leoliuuu/Eclectronics_final/image_scripts/batttery_0.jpg

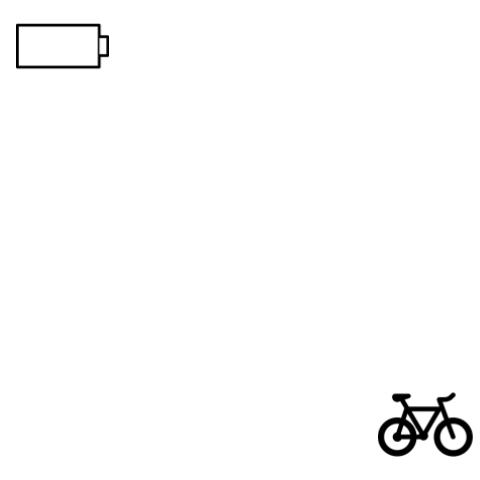
image_scripts/batttery_0.jpg
