leoliuuu/Eclectronics_final/image_scripts/full_battery.jpg

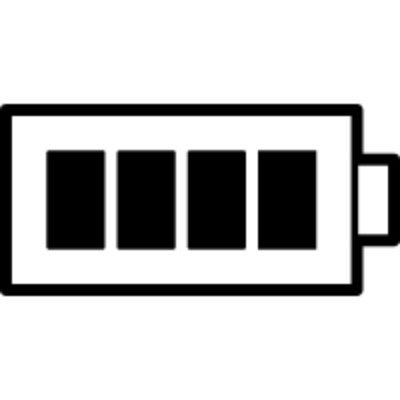
image_scripts/full_battery.jpg
