leoliuuu/Eclectronics_final/final/3dshapes/CSTNE.step

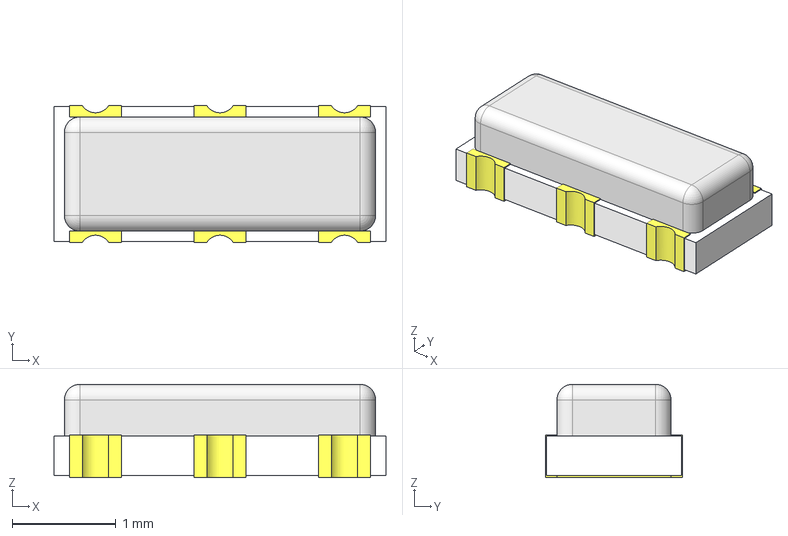
[picture p4: CAD file, 2019-04-07]
final/3dshapes/CSTNE.step
3.20 x 1.32 x 0.9 mm
