leoliuuu/Eclectronics_final/final/3dshapes/QFN-32_5x5.stp

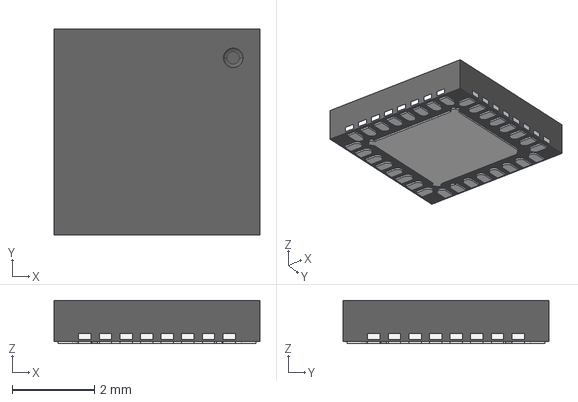
[picture p5: CAD file, 2019-04-07]
final/3dshapes/QFN-32_5x5.stp
5.00 x 5.00 x 1.05 mm
