leoliuuu/Eclectronics_final/image_scripts/test_image.png

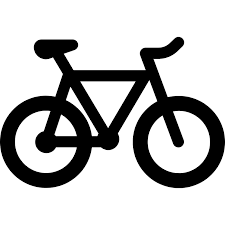
image_scripts/test_image.png
