leoliuuu/Eclectronics_final/final/sensor_board.kicad_pcb

## KiCad design final/sensor_board.kicad_pcb (2019-04-29)

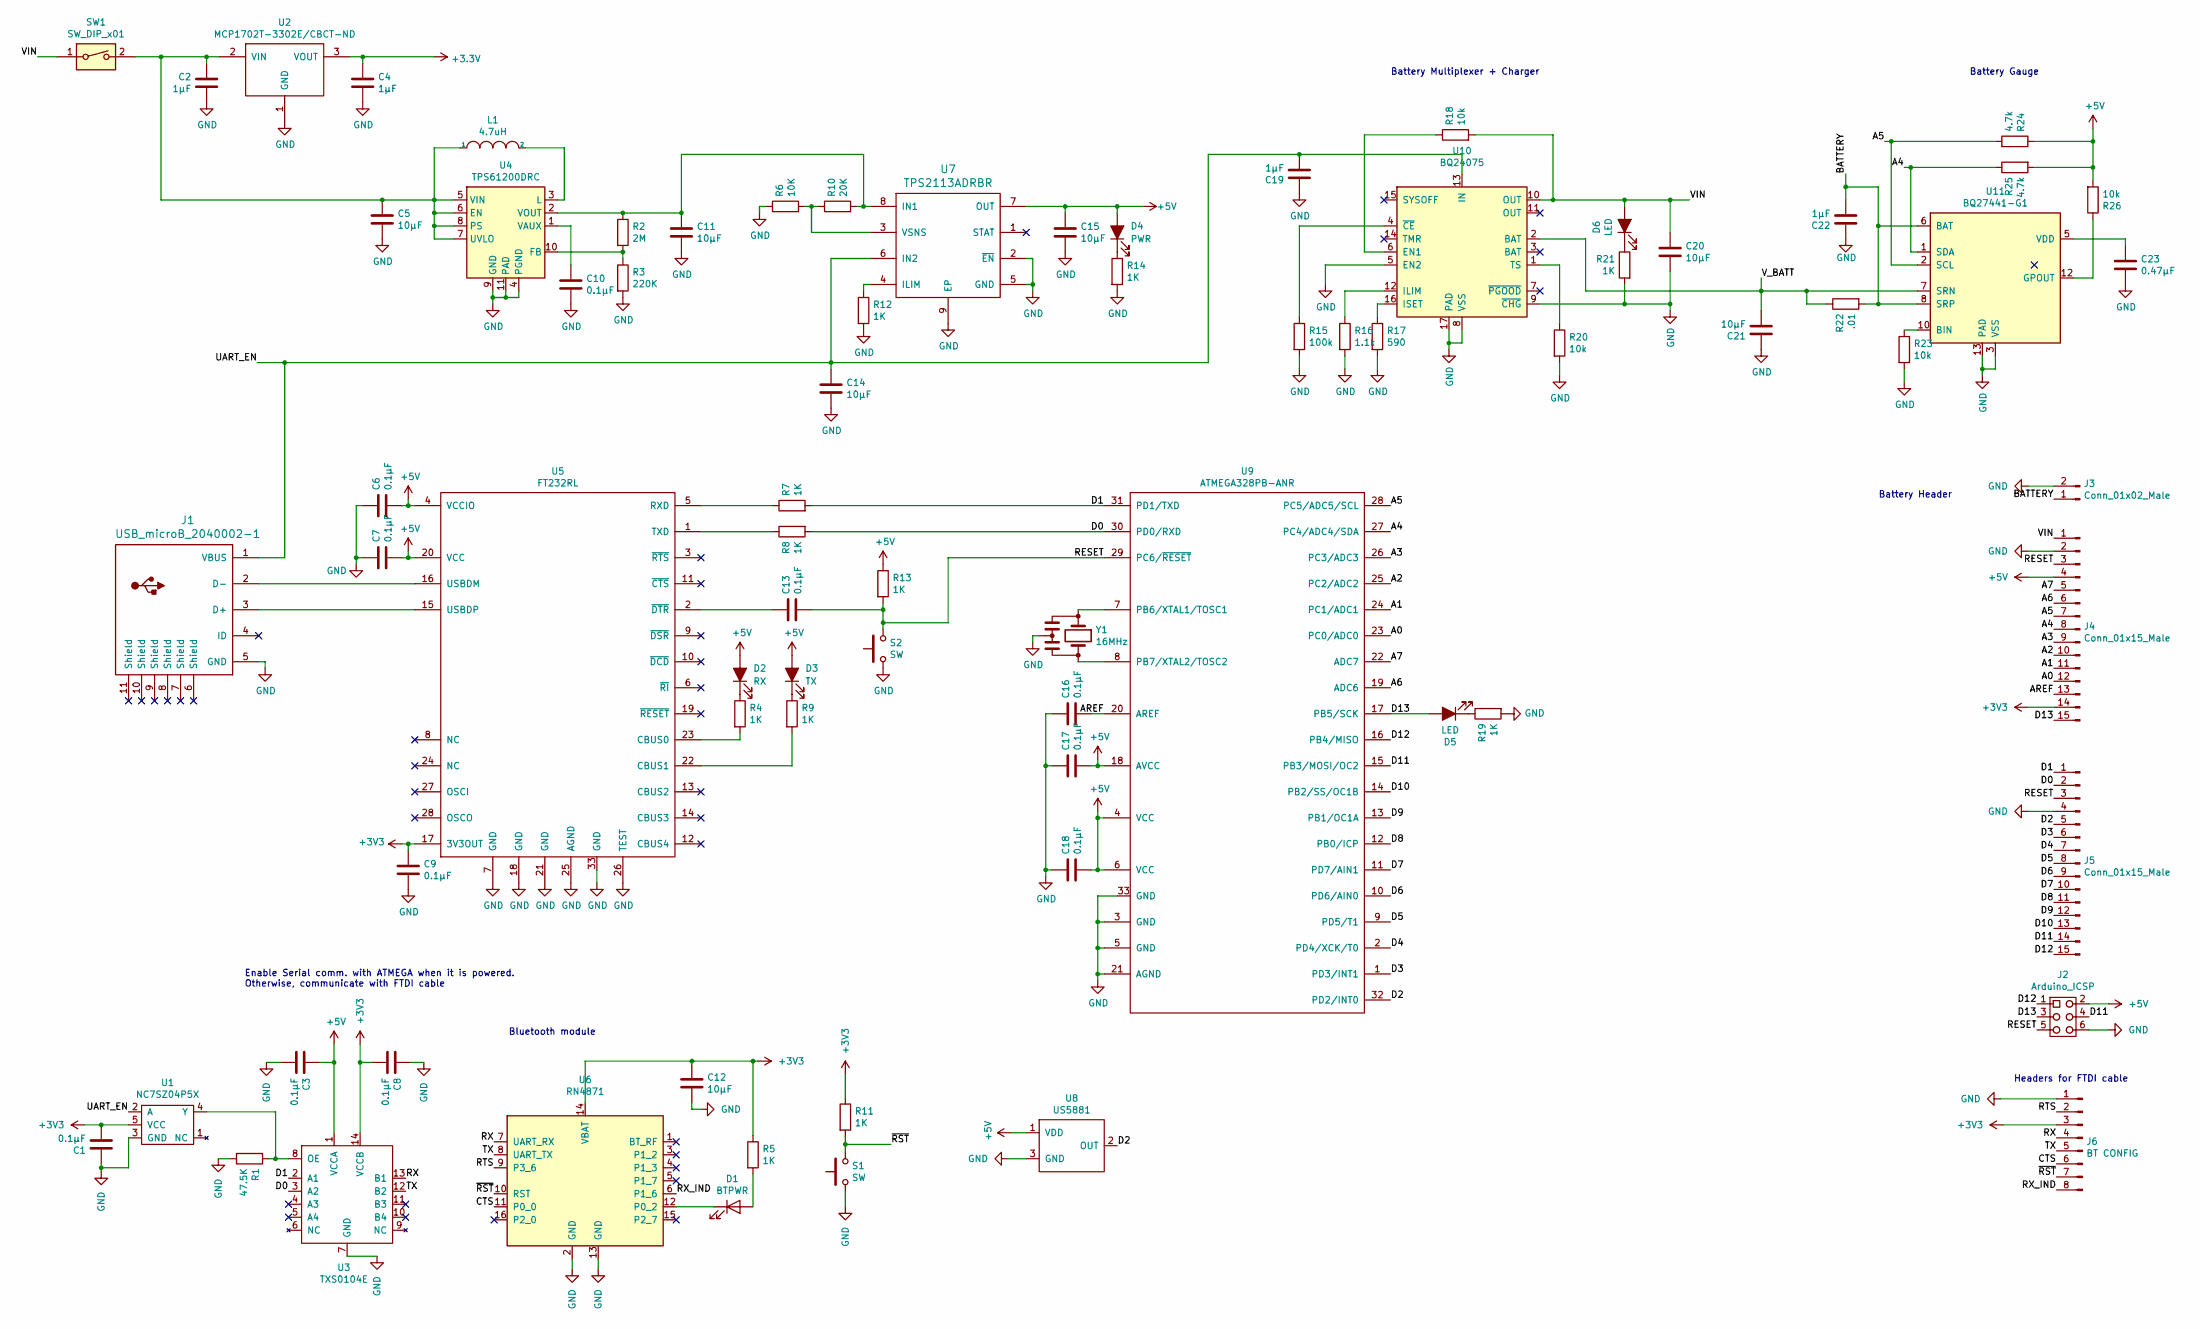
[picture p7: schematic sensor_board.sch]

Parts:
C1, C3, C6, C7, C8, C9, C10, C13, C16, C17, C18: 0.1µF; C_0603_1608Metric
C2, C4, C19, C22: 1µF; C_0603_1608Metric
C5, C11, C20, C21: 10µF; C_0603_1608Metric
C12, C14, C15: 10µF; C_0805_2012Metric
C23: 0.47µF; C_0402_1005Metric
D1: BTPWR; LED_0805_2012Metric
D2: RX; LED_0805_2012Metric
D3: TX; LED_0805_2012Metric
D4: PWR; LED_0805_2012Metric
D5, D6: LED; LED_0805_2012Metric
J1: USB_microB_2040002-1
J2: Arduino_ICSP
J3: Conn_01x02_Male; JST-2-SMD
J4, J5: Conn_01x15_Male; PinHeader_1x15_P2.54mm_Vertical
J6: BT CONFIG; PinHeader_1x08_P2.54mm_Vertical
L1: 4.7uH; CDRH2D18HP
R1: 47.5K; R_0603_1608Metric
R2: 2M; R_0603_1608Metric
R3: 220K; R_0603_1608Metric
R4, R5, R7, R8, R9, R11, R12, R13, R14, R19, R21: 1K; R_0603_1608Metric
R6: 10K; R_0603_1608Metric
R10: 20K; R_0603_1608Metric
R15: 100k; R_0603_1608Metric
R16: 1.1k; R_0603_1608Metric
R17: 590; R_0603_1608Metric
R18, R20, R23, R26: 10k; R_0603_1608Metric
R22: .01; R_0603_1608Metric
R24, R25: 4.7k; R_0603_1608Metric
S1, S2: SW; SW_SPST_B3U-1000P
SW1: SW_DIP_x01; KAE01SGGt
U1: NC7SZ04P5X
U2: MCP1702T-3302E/CBCT-ND; SOT-23
U3: TXS0104E; txs0104e
U4: TPS61200DRC
U5: FT232RL; FT232RQ
U6: RN4871; Microchip_RN4871
U7: TPS2113ADRBR
U8: US5881; TSOT-3L
U9: ATMEGA328PB-ANR; Atmega328pb
U10: BQ24075
U11: BQ27441-G1; Texas_S-PDSO-N12
Y1: 16MHz; CSTNE

Connections:
+5V: C3.1, C6.2, C7.2, C15.1, C17.2, C18.2, D2.2 (A), D3.2 (A), D4.2 (A), J2.2, J4.4, R13.1, R24.1, R25.2, R26.2, U3.1 (VCCA), U5.4 (VCCIO), U5.20 (VCC), U7.7 (OUT), U8.1 (VDD), U9.4 (VCC), U9.6 (VCC), U9.18 (AVCC)
/A0: J4.12, U9.23 (PC0/ADC0)
/A1: J4.11, U9.24 (PC1/ADC1)
/A2: J4.10, U9.25 (PC2/ADC2)
/A3: J4.9, U9.26 (PC3/ADC3)
/A4: J4.8, R25.1, U9.27 (PC4/ADC4/SDA), U11.1 (SDA)
/A5: J4.7, R24.2, U9.28 (PC5/ADC5/SCL), U11.2 (SCL)
/A6: J4.6, U9.19 (ADC6)
/A7: J4.5, U9.22 (ADC7)
/AREF: C16.2, J4.13, U9.20 (AREF)
/BATTERY: C22.2, J3.1, R22.2, U11.6 (BAT), U11.8 (SRP)
/CTS: J6.6, U6.11 (P0_0)
/D0: J5.2, R8.2, U3.3 (A2), U9.30 (PD0/RXD)
/D1: J5.1, R7.2, U3.2 (A1), U9.31 (PD1/TXD)
/D2: J5.5, U8.2 (OUT), U9.32 (PD2/INT0)
/D3: J5.6, U9.1 (PD3/INT1)
/D4: J5.7, U9.2 (PD4/XCK/T0)
/D5: J5.8, U9.9 (PD5/T1)
/D6: J5.9, U9.10 (PD6/AIN0)
/D7: J5.10, U9.11 (PD7/AIN1)
/D8: J5.11, U9.12 (PB0/ICP)
/D9: J5.12, U9.13 (PB1/OC1A)
/D10: J5.13, U9.14 (PB2/SS/OC1B)
/D11: J2.4, J5.14, U9.15 (PB3/MOSI/OC2)
/D12: J2.1, J5.15, U9.16 (PB4/MISO)
/D13: D5.2 (A), J2.3, J4.15, U9.17 (PB5/SCK)
/RESET: C13.2, J2.5, J4.3, J5.3, R13.2, S2.2, U9.29 (PC6/~RESET)
/RTS: J6.2, U6.9 (P3_6)
/RX: J6.4, U3.13 (B1), U6.7 (UART_RX)
/RX_IND: J6.8, U6.6 (P1_6)
/TX: J6.5, U3.12 (B2), U6.8 (UART_TX)
/UART_EN: C14.1, C19.2, J1.1 (VBUS), U1.2 (A), U7.6 (IN2), U10.13 (IN)
/VIN: C20.1, D6.2 (A), J4.1, R18.2, SW1.1, U10.10 (OUT)
/V_BATT: C21.2, R22.1, U10.2 (BAT), U11.7 (SRN)
/~RST: J6.7, R11.2, S1.2, U6.10 (RST)
GND: C1.1, C2.2, C3.2, C4.2, C5.2, C6.1, C7.1, C8.1, C9.2, C10.2, C11.2, C12.2, C14.2, C15.2, C16.1, C17.1, C18.1, C19.1, C20.2, C21.1, C22.1, C23.2, J1.5 (GND), J2.6, J3.2, J4.2, J5.4, J6.1, R1.2, R3.2, R6.1, R12.2, R14.2, R15.2, R16.2, R17.2, R19.2, R20.2, R21.2, R23.2, S1.1, S2.1, U1.3 (GND), U2.1 (GND), U3.7 (GND), U4.4 (PGND), U4.9 (GND), U4.11 (PAD), U5.7 (GND), U5.18 (GND), U5.21 (GND), U5.25 (AGND), U5.26 (TEST), U5.33 (GND), U6.2 (GND), U6.13 (GND), U7.2 (~EN), U7.5 (GND), U7.9 (EP), U8.3 (GND), U9.3 (GND), U9.5 (GND), U9.21 (AGND), U9.33 (GND), U10.5 (EN2), U10.8 (VSS), U10.9 (~CHG), U10.17 (PAD), U11.3 (VSS), U11.13 (PAD), Y1.2
unnamed: C2.1, C5.1, L1.1, SW1.2, U2.2 (VIN), U4.5 (VIN), U4.6 (EN), U4.7 (UVLO), U4.8 (PS)
unnamed: C10.1, U4.1 (VAUX)
unnamed: C11.1, R2.1, R10.2, U4.2 (VOUT), U7.8 (IN1)
unnamed: C13.1, U5.2 (~DTR)
unnamed: C23.1, U11.5 (VDD)
unnamed: D1.1 (K), U6.12 (P0_2)
unnamed: D1.2 (A), R5.2
unnamed: D2.1 (K), R4.1
unnamed: D3.1 (K), R9.1
unnamed: D4.1 (K), R14.1
unnamed: D5.1 (K), R19.1
unnamed: D6.1 (K), R21.1
unnamed: J1.2 (D-), U5.16 (USBDM)
unnamed: J1.3 (D+), U5.15 (USBDP)
unnamed: L1.2, U4.3 (L)
unnamed: R1.1, U1.4 (Y), U3.8 (OE)
unnamed: R2.2, R3.1, U4.10 (FB)
unnamed: R4.2, U5.23 (CBUS0)
unnamed: R7.1, U5.5 (RXD)
unnamed: R8.1, U5.1 (TXD)
unnamed: R9.2, U5.22 (CBUS1)
unnamed: R6.2, R10.1, U7.3 (VSNS)
unnamed: R12.1, U7.4 (ILIM)
unnamed: R15.1, U10.4 (~CE)
unnamed: R16.1, U10.12 (ILIM)
unnamed: R17.1, U10.16 (ISET)
unnamed: R18.1, U10.6 (EN1)
unnamed: R20.1, U10.1 (TS)
unnamed: R23.1, U11.10 (BIN)
unnamed: R26.1, U11.12 (GPOUT)
unnamed: U9.7 (PB6/XTAL1/TOSC1), Y1.1
unnamed: U9.8 (PB7/XTAL2/TOSC2), Y1.3

Notes on the sheet:
Headers for FTDI cable
Enable Serial comm. with ATMEGA when it is powered. Otherwise, communicate with FTDI cable
Bluetooth module
Battery Multiplexer + Charger
Battery Gauge
Battery Header

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
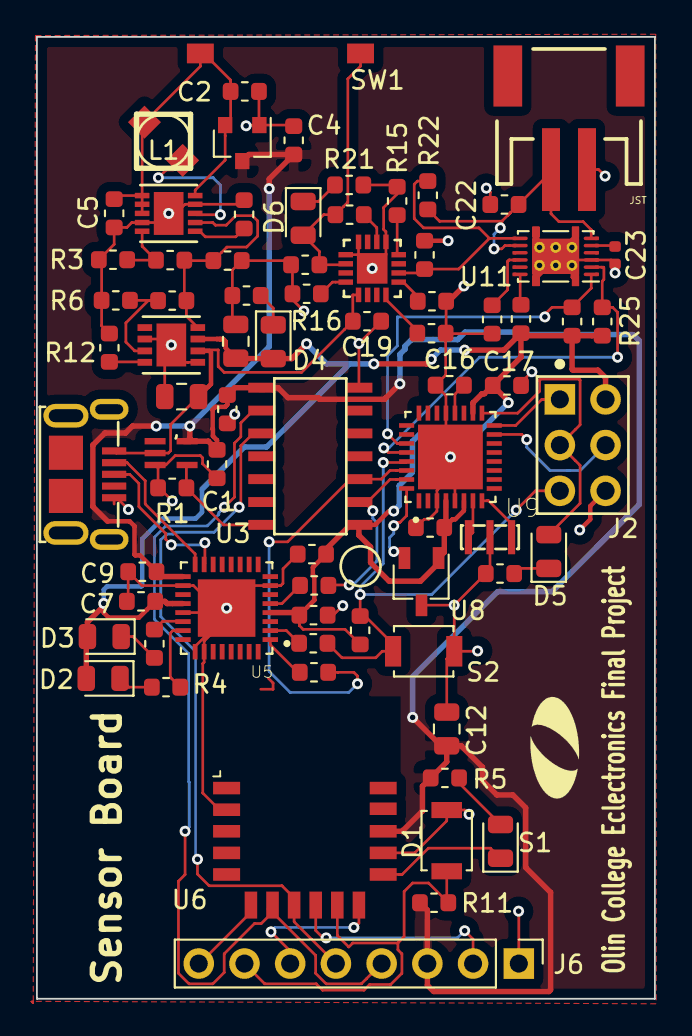
[picture p8: board sensor_board.kicad_pcb from above]

Board: 2 copper layers, 34.3 x 53.4 mm, 76 parts (0 on the bottom side), 55 nets.

Other parts of the board:
OlinLogo: G***; OlinLogo
