leoliuuu/Eclectronics_final/main_board/image_data.h

namespace imagedata {
  
extern const unsigned char background_0[];

extern const unsigned char background_25[];

extern const unsigned char background_50[];

extern const unsigned char background_75[];

extern const unsigned char background_100[];

}   // namespace imagedata
