leoliuuu/Eclectronics_final/(commit log)

2019-04-02 Initialize project for display subsystem
    [display_schematic.kicad_pcb, display_schematic.sch]
2019-04-02 Populate with first pass schematic
    [display_schematic.sch]
2019-04-07 Finish schematics
    [CSTNE.step, DFN-8-3x3-0_5.STEP, QFN-32_5x5.stp, main_board.sch, mp3b.kicad_pcb, sensor_board.sch]
2019-04-08 Power Added
    [_saved_main_board.sch, main_board.sch, mp3b.kicad_pcb, sensor_board.sch]
2019-04-08 Revert "Power Added"
    This reverts commit 6e914afe56b2ec69bab62107e6ad54a93b9b43d6.
    [_saved_main_board.sch, main_board.sch, mp3b.kicad_pcb, sensor_board.sch]
2019-04-08 Add mode button
    [main_board.sch]
2019-04-08 Fix merge conflicts
    [_saved_main_board.sch, sensor_board.sch]
2019-04-08 Add mode button.
    [main_board.sch]
2019-04-08 Add diode to 3V3 output of FTDI and power display from Lin Reg.
    [main_board.sch, sensor_board.sch]
2019-04-09 Hook up reset on BT to MCU
    [main_board.sch, sensor_board.sch]
2019-04-11 Added Power Schematic
    [main_board.sch, sensor_board.sch]
2019-04-11 Update Power 4/11
    [sensor_board.sch]
2019-04-11 Ground pins
    [sensor_board.sch]
2019-04-11 Made Boards Better
    [main_board.sch, sensor_board.sch]
2019-04-14 Update Main Board
    [main_board.sch]
2019-04-16 Add inverter and change enable
    [main_board.sch, sensor_board.sch]
2019-04-16 Linear Regulator -> Boost DC-DC
    [main_board.sch, sensor_board.sch]
2019-04-16 Footprint assignment
    [sensor_board.sch]
2019-04-16 Footprint Assigned
    [main_board.sch, sensor_board.sch]
2019-04-16 Change pull up/down resistor values for logic level enable pins
    [main_board.sch, sensor_board.sch]
2019-04-16 Made footprints
    [sensor_board.sch]
2019-04-16 Assign new footprint to capacitor
    [main_board.sch, sensor_board.sch]
2019-04-16 Add Footprint for Inductor
2019-04-16 made footprint
    [sensor_board.sch]
2019-04-17 added new footprints and assignments
    [main_board.sch, sensor_board.sch]
2019-04-17 Assigned footprints
    [main_board.sch]
2019-04-18 Footprint additions
    [main_board.sch]
2019-04-18 Assign footprints
    [main_board.sch]
2019-04-18 Create footprints
2019-04-18 Bluetooth Power LED Footprint Assigned
    [main_board.sch]
2019-04-18 Add assignment for small logic converter
    [main_board.sch, sensor_board.sch]
2019-04-18 Final Footprints
    [main_board.sch, sensor_board.sch]
2019-04-18 Fixed bad junction
    [sensor_board.sch]
2019-04-18 Fixed Something
    [sensor_board.sch]
2019-04-18 Footprint Update + layout main
    [main_board.kicad_pcb]
2019-04-18 Change jst footprint assignment
    [main_board.sch]
2019-04-22 board layout position complete
    [mp3b.kicad_pcb, sensor_board.kicad_pcb]
2019-04-22 sensor board layout updates
    [sensor_board.kicad_pcb]
2019-04-22 Add ground pad to QFNs
    [main_board.sch, sensor_board.sch]
2019-04-22 Updated Layout
    [main_board.kicad_pcb]
2019-04-22 Update 1
    [main_board.kicad_pcb, main_board.sch]
2019-04-22 Update 2
    [main_board.kicad_pcb]
2019-04-23 sensor board layout progress
    [sensor_board.kicad_pcb, sensor_board.sch]
2019-04-23 Update 3
    [main_board.kicad_pcb]
2019-04-24 changes to senor layout
    [main_board.sch, sensor_board.kicad_pcb, sensor_board.sch]
2019-04-25 Add library that compiles correctly
    [epd1in54-demo.ino, imagedata.cpp]
2019-04-25 sensor board layout complete
    [sensor_board.kicad_pcb]
2019-04-25 sensor board final fix and is now ready for fab
    [sensor_board.kicad_pcb]
2019-04-25 Fixed Silk
    [main_board.kicad_pcb]
2019-04-25 text added
    [sensor_board.kicad_pcb]
2019-04-29 Add script for main board
2019-05-02 Add code for the sensor board
2019-05-07 Add functions for fuel guage and battery display
